nezbyte/desk_lamp/README.md

# desk_lamp
 FPGA based desk lamp upgrade
