nezbyte/desk_lamp/schematic.pdf

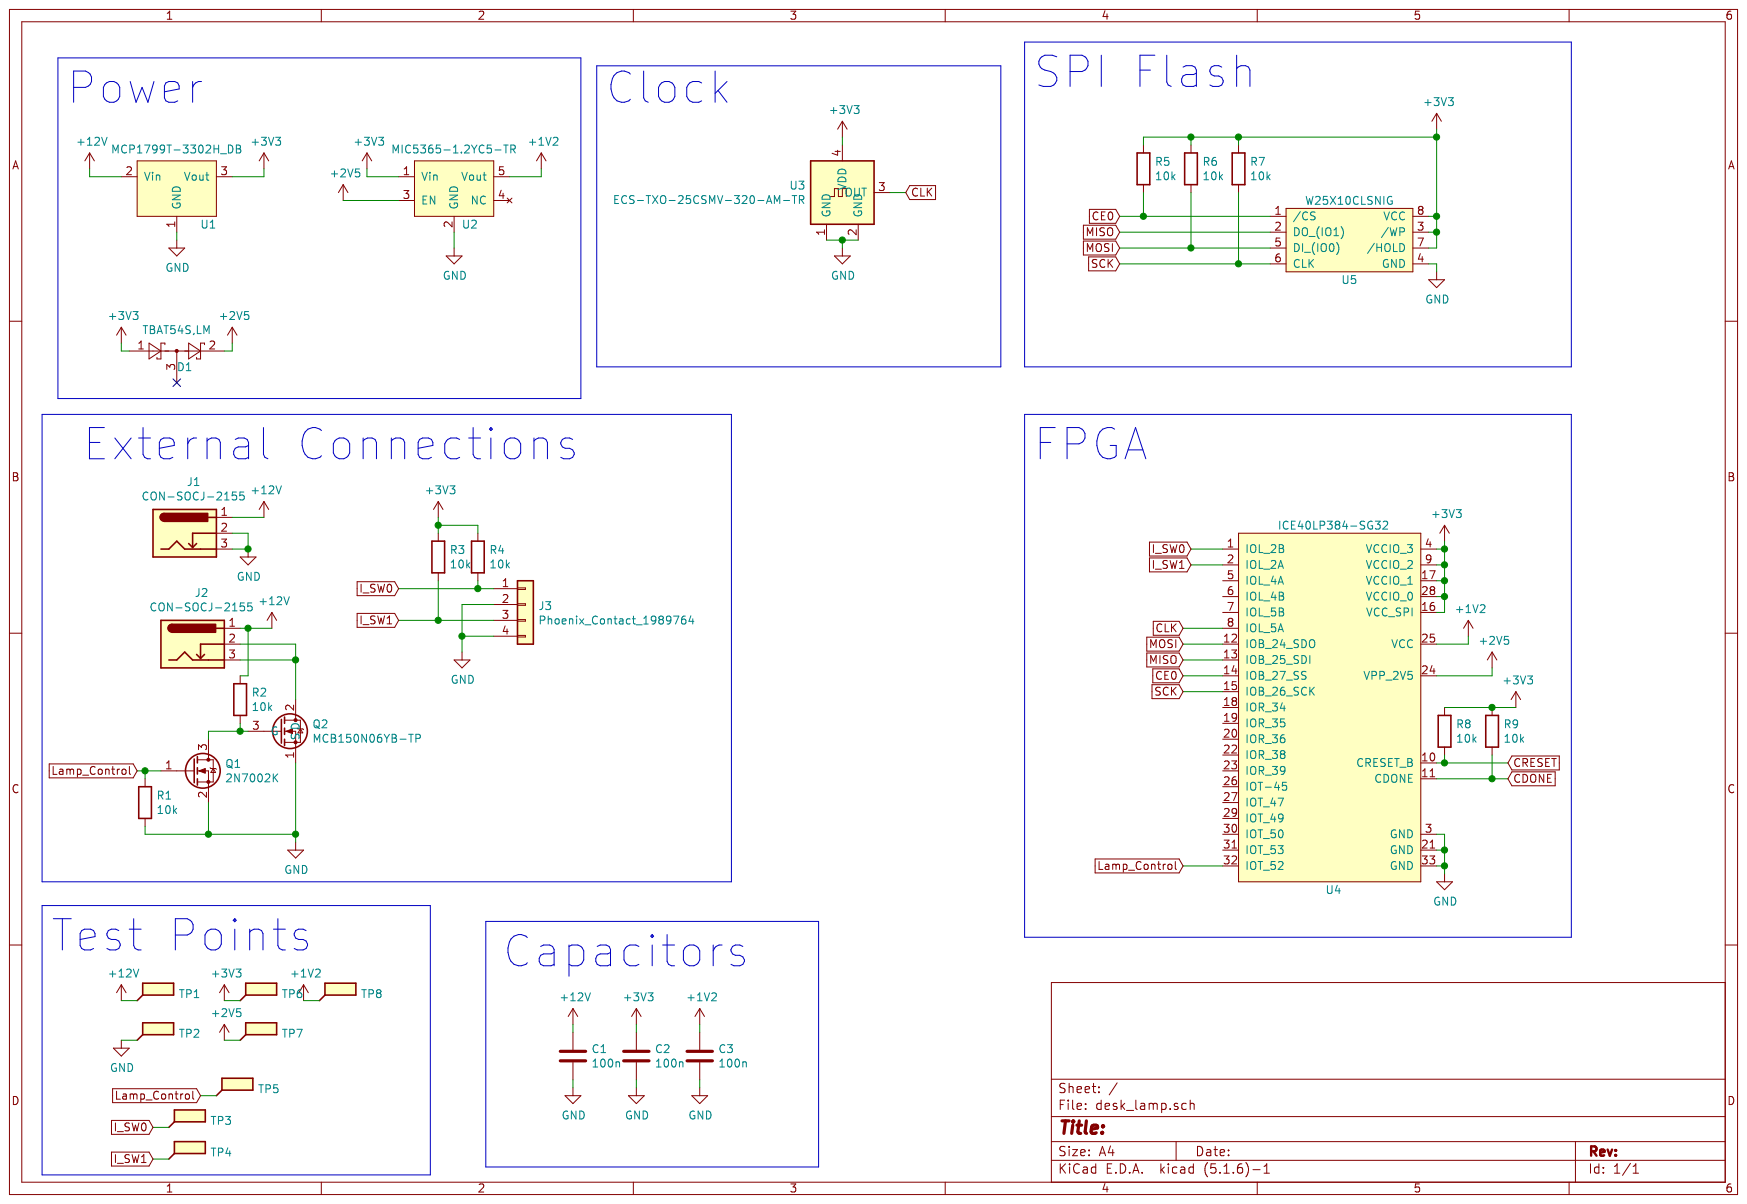
[picture p1: page 1]
