nezbyte/desk_lamp/layout.pdf

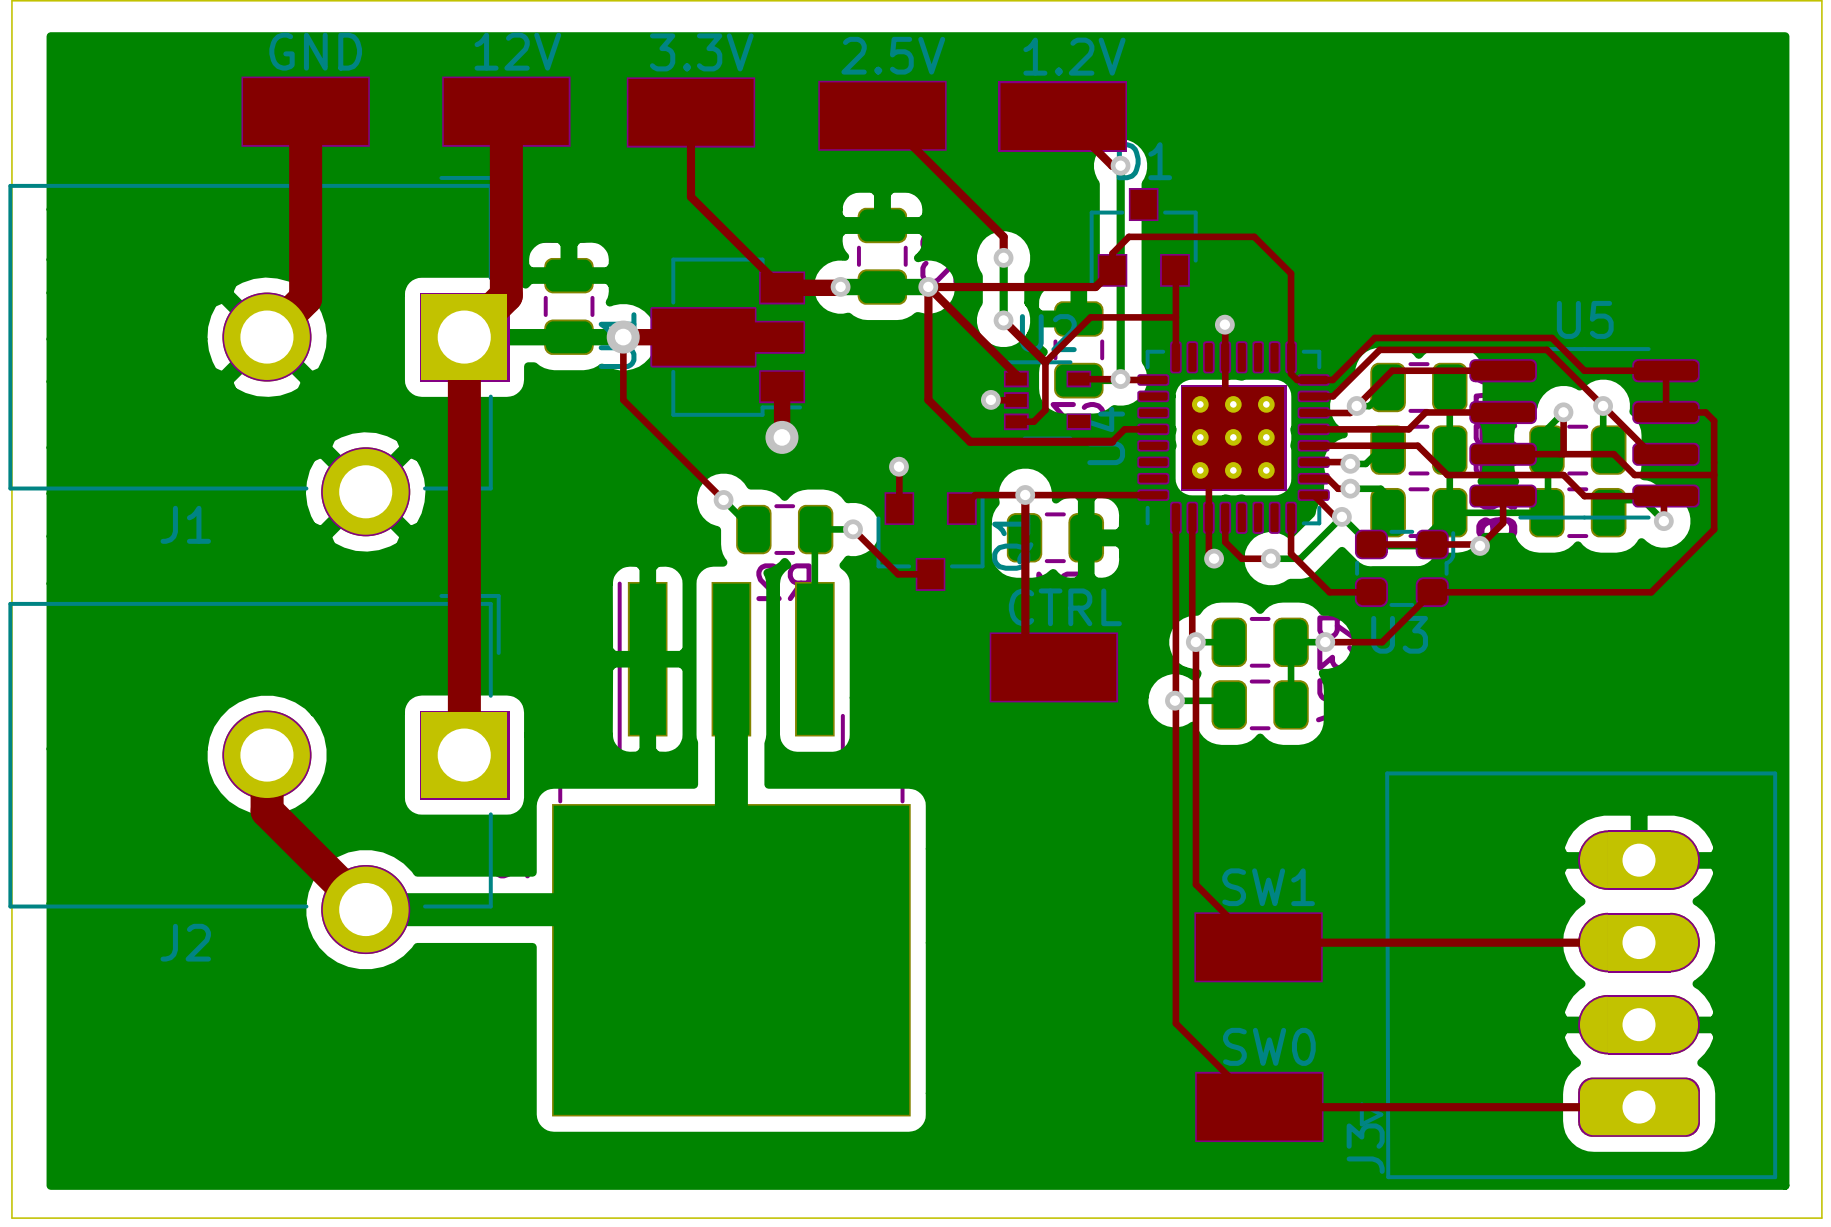
[picture p2: page 1]
