nezbyte/desk_lamp/desk_lamp.kicad_pcb

## KiCad design desk_lamp.kicad_pcb (2020-10-06)

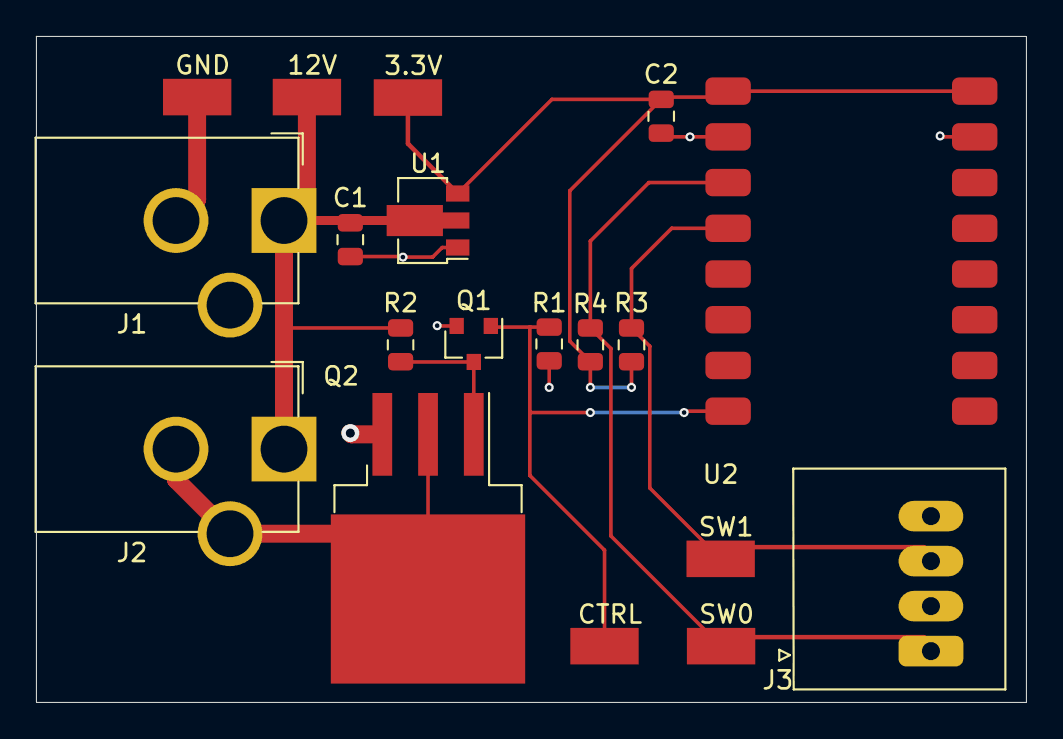
[picture p3: board desk_lamp.kicad_pcb from above]

Board: 2 copper layers, 55.0 x 37.0 mm, 19 parts (0 on the bottom side), 8 nets.

Parts:
C1, C2: 100n; C_0805_2012Metric
J1, J2: CON-SOCJ-2155; BarrelJack_CUI_PJ-102AH_Horizontal
J3: Phoenix_Contact_1989764; PhoenixContact_PTSA_0,5_4-2,5-F_P2.50mm_Horizontal
Q1: 2N7002K; SOT-23
Q2: MCB150N06YB-TP; TO-263-3_TabPin2
R1, R2, R3, R4: 10k; R_0805_2012Metric
TP1: 12V; TestPoint_5019
TP2: GND; TestPoint_5019
TP3: SW0; TestPoint_5019
TP4: SW1; TestPoint_5019
TP5: CTRL; TestPoint_5019
TP6: 3.3V; TestPoint_5019
U1: MCP1703T-3302E/MB; SOT-89-3
U2: ICE30LP384_QFN32_MODULE

Connections:
+3V3: C2.1, R3.1, R4.1, TP6.1, U1.3, U2.1, U2.16
+12V: C1.1, J1.1, J2.1, R2.1, TP1.1, U1.2
GND: C1.2, C2.2, J1.2, J1.3, J3.2, J3.4, Q1.2, Q2.3, R1.2, TP2.1, U1.1, U2.2, U2.15
I_SW0: J3.1, R4.2, TP3.1, U2.3
I_SW1: J3.3, R3.2, TP4.1, U2.4
Lamp_Control: Q1.1, R1.1, TP5.1, U2.8
unnamed: J2.2, J2.3, Q2.2
unnamed: Q1.3, Q2.1, R2.2
