nezbyte/desk_lamp/(commit log)

2020-09-18 Add kicad gitignore
2020-09-18 Add kicad files
    [desk_lamp.kicad_pcb, desk_lamp.sch]
2020-09-18 added gerbers
    [desk_lamp.kicad_pcb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]
2020-09-18 updated gitignore; adding BOM and GBRs
    [desk_lamp-B_Cu.gbr, desk_lamp-B_Mask.gbr, desk_lamp-B_Paste.gbr, desk_lamp-B_SilkS.gbr, desk_lamp-Edge_Cuts.gbr, desk_lamp-F_Cu.gbr, desk_lamp-F_Mask.gbr, desk_lamp-F_Paste.gbr]
2020-10-05 Fixed mosfet swapped pins
    Gate and Drain pins were swapped.
    [desk_lamp.kicad_pcb, desk_lamp.sch]
2020-10-05 Resized barrel jack connector holes
    Barrel jack connector holes were found to be too small to fit component. Updated footprint and layout to accomodate larger holes.
    [desk_lamp.kicad_pcb]
2020-10-06 Corrected TCXO and 3V3 LDO
    TCXO was replaced with 25MHz that is no longer 0.8Vpp.
    LDO did not match footprint. Replaced with compatible model that matched fabbed footprint.
    Gerbers updated and could be sent to fab house if desired.
    [desk_lamp-B_Cu.gbr, desk_lamp-B_Mask.gbr, desk_lamp-B_Paste.gbr, desk_lamp-B_SilkS.gbr, desk_lamp-Edge_Cuts.gbr, desk_lamp-F_Cu.gbr, desk_lamp-F_Mask.gbr, desk_lamp-F_Paste.gbr]
2020-10-06 Switched to FPGA module
    Switched to FPGA module to make changes easier going forward.
    [desk_lamp-B_Cu.gbr, desk_lamp-B_Mask.gbr, desk_lamp-B_Paste.gbr, desk_lamp-B_SilkS.gbr, desk_lamp-Edge_Cuts.gbr, desk_lamp-F_Cu.gbr, desk_lamp-F_Mask.gbr, desk_lamp-F_Paste.gbr]
